sakarlsson/speedo-and-odometer/README.md

# speedo-and-odometer
Arduino based speedometer and odometer

Made to work for my El Camino 1970 with a Holley Terminator X EFI.

The code is now a bit more generally useful.

The odometer is using a Adafruit Monochrome 128x32 I2C OLED graphic
display [ADA931].  It will store the current km reading in the eeprom
(using a rotating scheme to get more than the 100000 writes per cell).

The speedo is using the SwitechX25 lib.
Beware that this lib has a little flaw when it comes to the zero()
function.  It does not use its acceleration mechanism and steps
may stall.    You may need to tweak this in the SwitechX25.cpp 

```#define RESET_STEP_MICROSEC 800
```

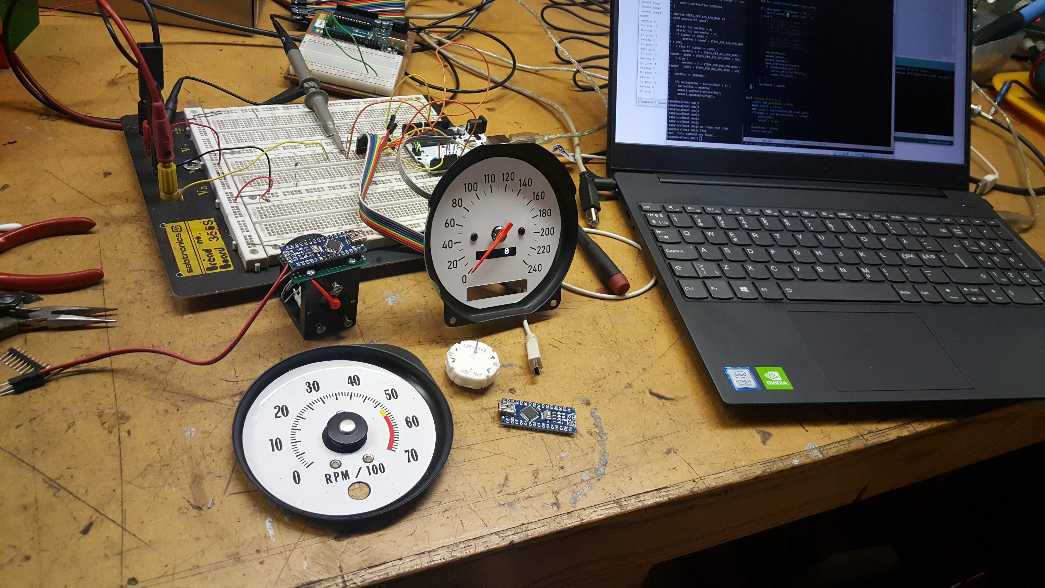
[picture p1: speedo-odo.jpg]
Speedo-odo and Tacho


## Usage

### Compile

Use the library manger to fetch the used libs. These are needed:

    #include <Adafruit_GFX.h>
    #include <Adafruit_SSD1306.h>

Compile and load the Arduino with the code using the normal Arduino IDE.

I use: 

	arduino-cli compile -b arduino:avr:nano
	arduino-cli upload -p /dev/ttyUSB0  -b arduino:avr:nano:cpu=atmega328old
	
	arduino-cli monitor  -p /dev/ttyUSB0

### Run

Use the Arduino serial console to configure the speedometer.
You need to issue the following commands:

* `set zeromark value`  To configure the position of the zero speed mark.
* `set maxmark value`   To configure the position of the maximum speed mark
* `set maxspeed value`  To configure what speed it is at the max speed mark

To help you figure out the positions you can use

    moveto position

It will move the dial to the poistion - the position is in terms steps of the Switec motor.
When you have found the position of zero, give `set zero <value>`, and the
position will be saved to the internal eeprom.  Proceed with finding the position for
the max speed mark. 

When you have set the above 3 parameters, you can try it out by simulating
a speed:

    speed 120

## General mounting etc

I used the Arduino Nano for a small form factor and milled out a plastic console
out of POM to hold it all together.

For the tachometer I had to CNC mill a new needle as I couldn't reuse the original.

The speedo will get power from the IGN 12+V, but the tachometer will have constant
battery power. As it will not otherwise be able to go to Zero when you turn off the IGN.

The tachometer code will enter Low Power mode when there are no pulses detected, and
did draw about 2-3 mA (after I desoldered the power LED on the Nano).

The Holley Terminator X was programmed to output the Speed on one of the free output pins.

# draw-gauge.py 

Is a small script that works with the Inkscape Simple Scripting extension 

## Useful links:

https://guy.carpenter.id.au/gaugette/2012/01/19/x12-quad-driver-chip/

### To find the X25 driver search for: 

X12.017 AX1201728 AX1201728SG SOP-28

## X27 motor pins 

The X27 168 has built in stops at 0 and max
Pin out: Poke the needle pin at your nose and orient the text X27 168 so you can read it.
         Then pin 1 is to the top left (protruding out on the the other side)
         pin 2 follows counter clock wise, then 3 and 4 which is to the top right.
