sakarlsson/speedo-and-odometer/PCB/PCB.kicad_pcb

## KiCad design PCB/PCB.kicad_pcb (2026-01-15)

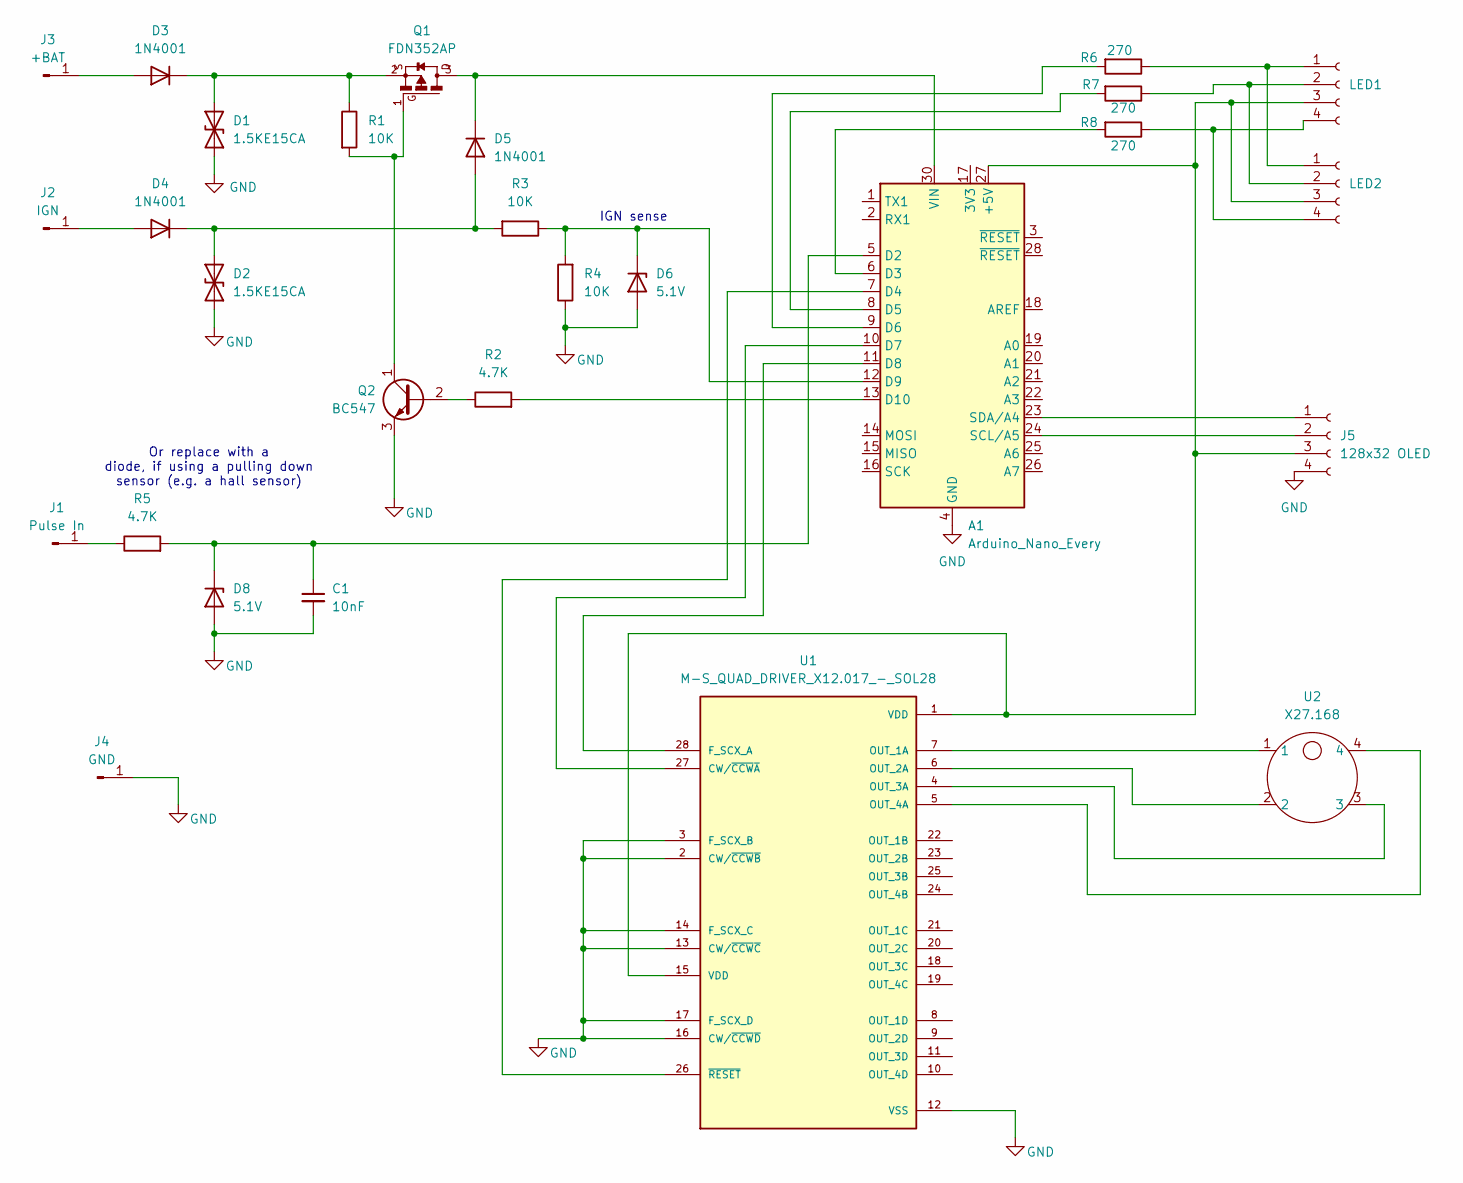
[picture p2: schematic PCB.kicad_sch]

Parts:
A1: Arduino_Nano_Every; Arduino_Nano
C1: 10nF; C_Disc_D7.5mm_W4.4mm_P5.00mm
D1, D2: 1.5KE15CA; D_DO-201AE_P5.08mm_Vertical_KathodeUp
D3, D4, D5: 1N4001; D_DO-41_SOD81_P3.81mm_Vertical_KathodeUp
D6, D8: 5.1V; D_DO-35_SOD27_P2.54mm_Vertical_KathodeUp
J1: Pulse In; SolderWire-0.5sqmm_1x01_D0.9mm_OD2.3mm
J2: IGN; SolderWire-0.5sqmm_1x01_D0.9mm_OD2.3mm
J3: +BAT; SolderWire-0.5sqmm_1x01_D0.9mm_OD2.3mm
J4: GND; SolderWire-0.5sqmm_1x01_D0.9mm_OD2.3mm
J5: 128x32 OLED; PinHeader_1x04_P2.54mm_Vertical
LED1: LED1; rgb-led
LED2: LED2; rgb-led
Q1: FDN352AP; SSOT-3
Q2: BC547; TO-92_Inline
R1, R3, R4: 10K; R_Axial_DIN0207_L6.3mm_D2.5mm_P2.54mm_Vertical
R2, R5: 4.7K; R_Axial_DIN0207_L6.3mm_D2.5mm_P2.54mm_Vertical
R6, R7, R8: 270; R_Axial_DIN0207_L6.3mm_D2.5mm_P2.54mm_Vertical
U1: M-S_QUAD_DRIVER_X12.017_-_SOL28; SOIC127P1028X264-28N; PARTREV --
U2: X27.168; x27.168

Connections:
GND: A1.4 (GND), A1.29 (GND), C1.2, D1.1 (A1), D2.1 (A1), D6.2 (A), D8.2 (A), J4.1, J5.4, Q2.3 (E), R4.1, U1.2 (CW/~CCW~B), U1.3 (F_SCX_B), U1.12 (VSS), U1.13 (CW/~CCW~C), U1.14 (F_SCX_C), U1.16 (CW/~CCW~D), U1.17 (F_SCX_D)
unnamed: A1.5 (D2), C1.1, D8.1 (K), R5.2
unnamed: A1.6 (D3), R8.2
unnamed: A1.7 (D4), U1.26 (~RESET)
unnamed: A1.8 (D5), R7.2
unnamed: A1.9 (D6), R6.2
unnamed: A1.10 (D7), U1.27 (CW/~CCW~A)
unnamed: A1.11 (D8), U1.28 (F_SCX_A)
unnamed: A1.12 (D9), D6.1 (K), R3.1, R4.2
unnamed: A1.13 (D10), R2.2
unnamed: A1.24 (SCL/A5), J5.2
unnamed: A1.23 (SDA/A4), J5.1
unnamed: A1.30 (VIN), D5.1 (K), Q1.3
unnamed: D1.2 (A2), D3.1 (K), Q1.2, R1.1
unnamed: D2.2 (A2), D4.1 (K), D5.2 (A), R3.2
unnamed: D3.2 (A), J3.1
unnamed: D4.2 (A), J2.1
unnamed: J1.1, R5.1
unnamed: LED1.1, LED2.1, R6.1
unnamed: LED1.2, LED2.2, R7.1
unnamed: LED1.4, LED2.4, R8.1
unnamed: Q2.2 (B), R2.1
unnamed: Q1.1, Q2.1 (C), R1.2
unnamed: U1.7 (OUT_1A), U2.1
unnamed: U1.6 (OUT_2A), U2.2
unnamed: U1.4 (OUT_3A), U2.3
unnamed: U1.5 (OUT_4A), U2.4
VDD: A1.27 (+5V), J5.3, LED1.3, LED2.3, U1.1 (VDD), U1.15 (VDD)

Notes on the sheet:
IGN sense
Or replace with a diode, if using a pulling down sensor (e.g. a hall sensor)

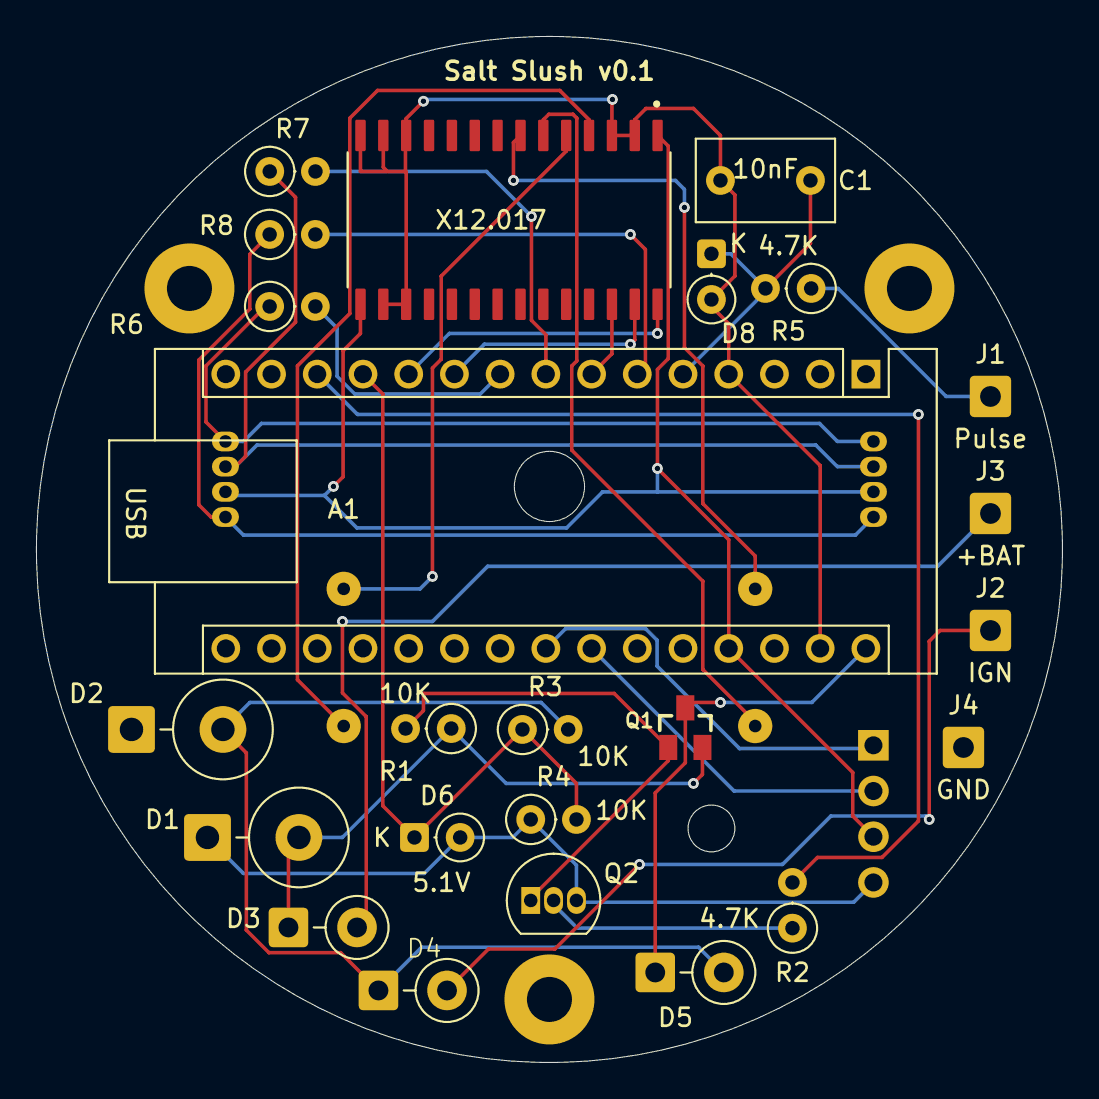
[picture p3: board PCB.kicad_pcb from above]

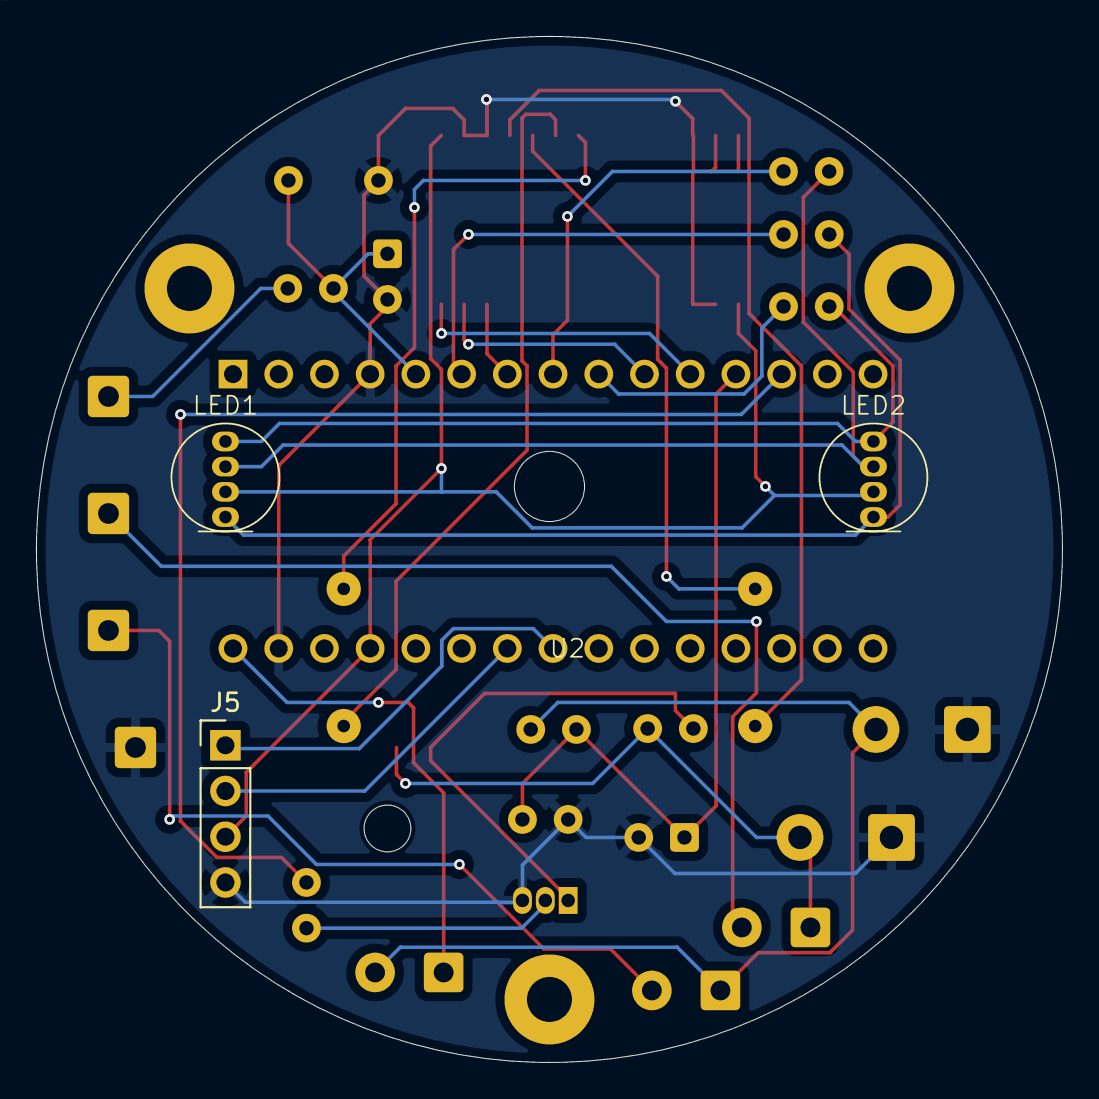
[picture p4: board PCB.kicad_pcb from below]

Board: 2 copper layers, 57.0 x 57.0 mm, 28 parts (4 on the bottom side), 28 nets.
