sakarlsson/speedo-and-odometer/(commit log)

2020-10-04 Reworked to be more generic.
    The old impl is in my-el-camino branch.
2025-10-04 New take using the X12.017 microstep driver
2026-01-15 Checkpoint after PCB 0.1 was sent to JLPCB
    speedo code remains to convertetd to uS pulse
    logic insteda of a speed based calculation
